roberttidey/BatteryChargerAdapter/Docs/AdapterCase2.jpg

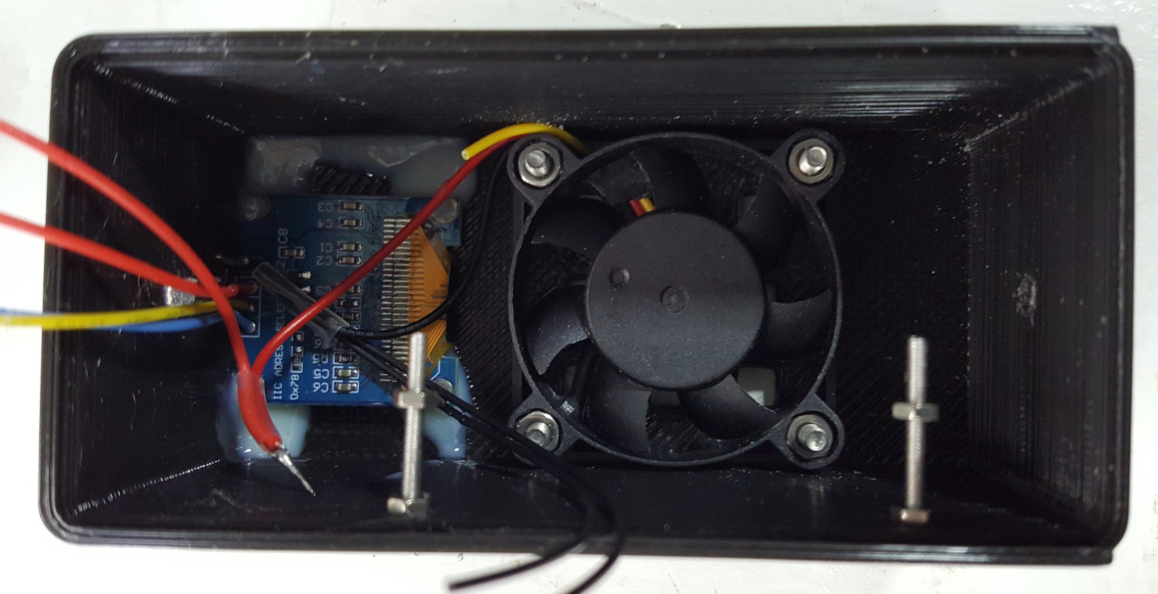
Docs/AdapterCase2.jpg
