roberttidey/BatteryChargerAdapter/Docs/xl4015Front.jpg

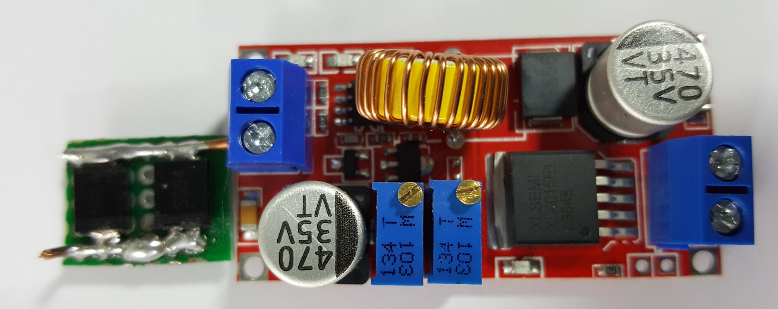
Docs/xl4015Front.jpg
