roberttidey/BatteryChargerAdapter/Docs/Adapter.jpg

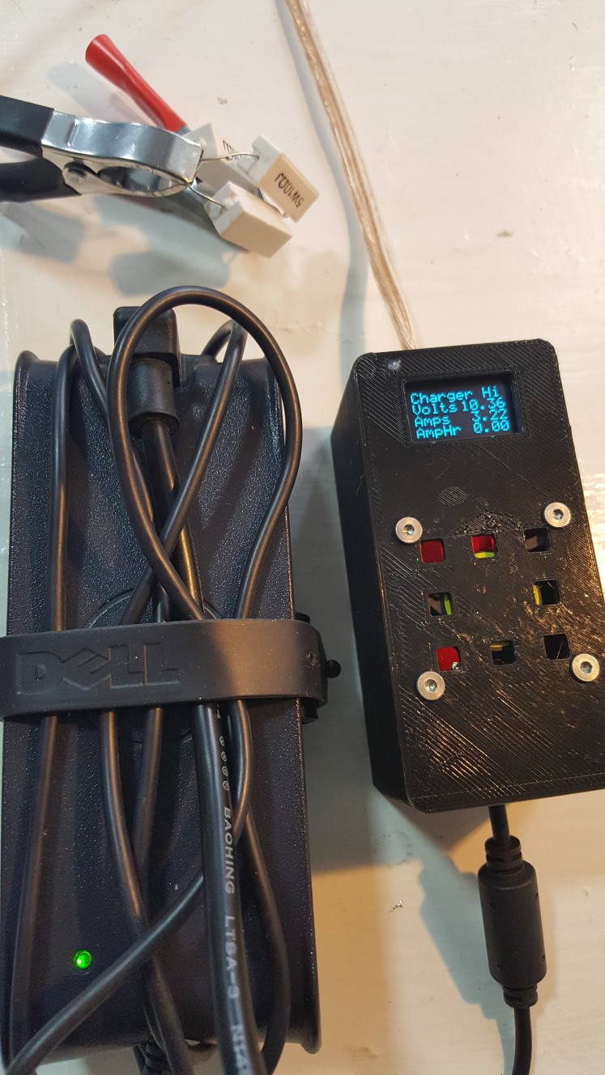
Docs/Adapter.jpg
