roberttidey/BatteryChargerAdapter/Docs/AdapterCase1.jpg

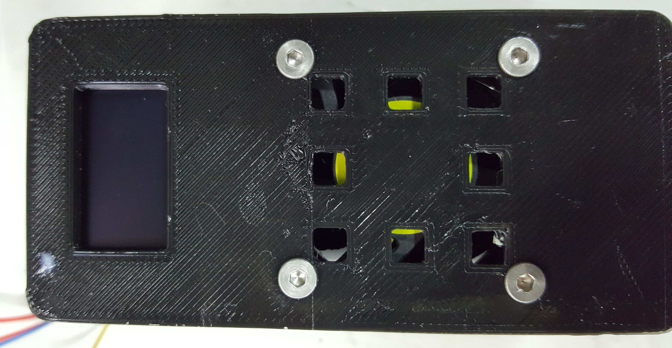
Docs/AdapterCase1.jpg
