roberttidey/BatteryChargerAdapter/Docs/AdapterCase3.jpg

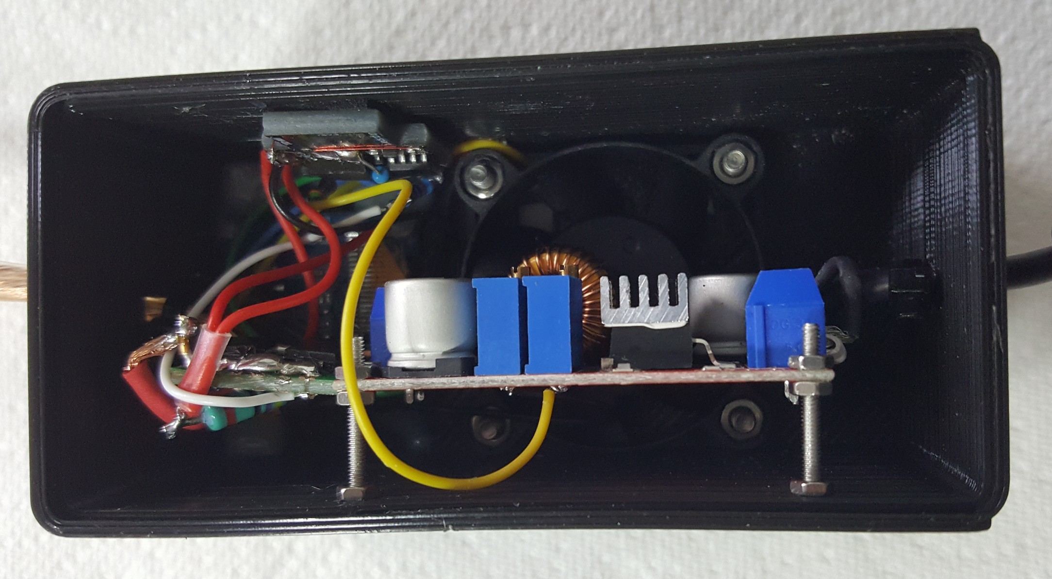
Docs/AdapterCase3.jpg
