roberttidey/BatteryChargerAdapter/Docs/Schematic_Battery Charger12VAdapter.jpg

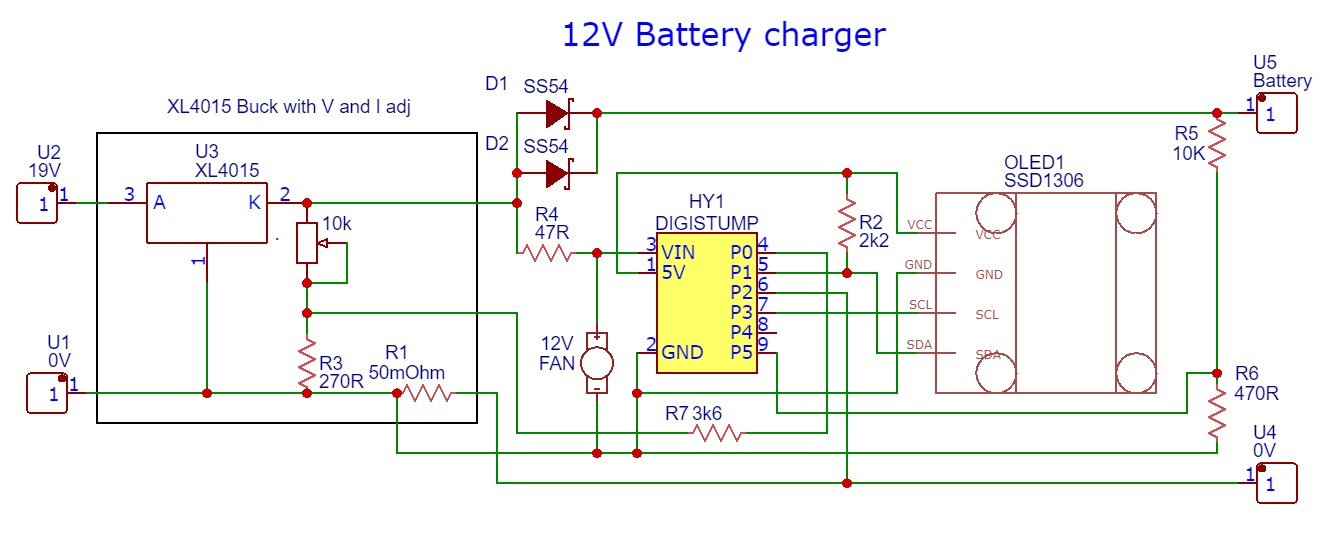
Docs/Schematic_Battery Charger12VAdapter.jpg
