roberttidey/BatteryChargerAdapter/Docs/xl4015back.jpg

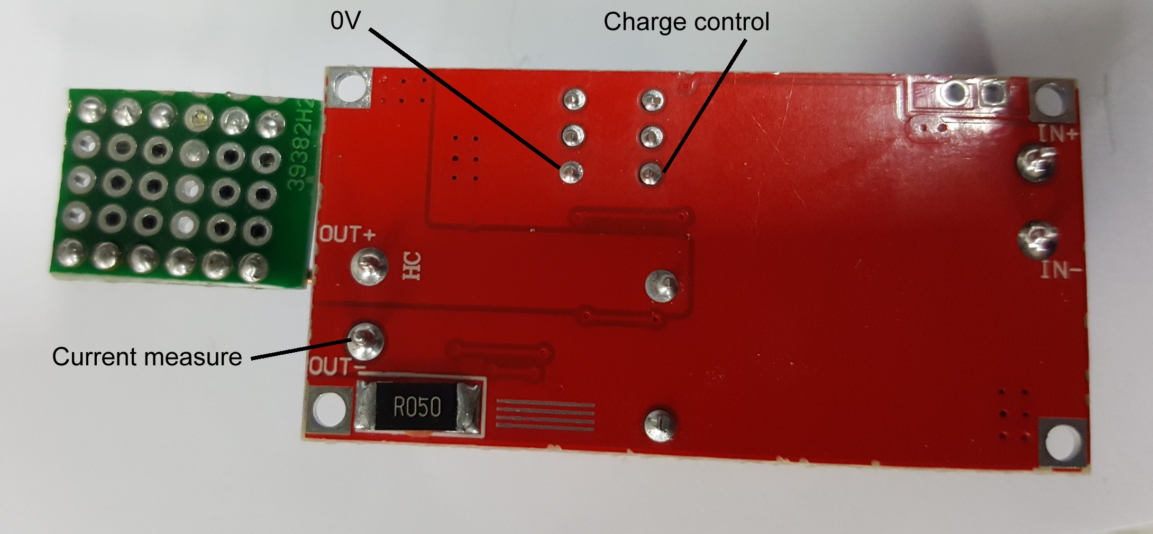
Docs/xl4015back.jpg
